1m4n00b6292/UNIDRIVE-V1/Pictures/UNIDRIVE_3D_Back.png

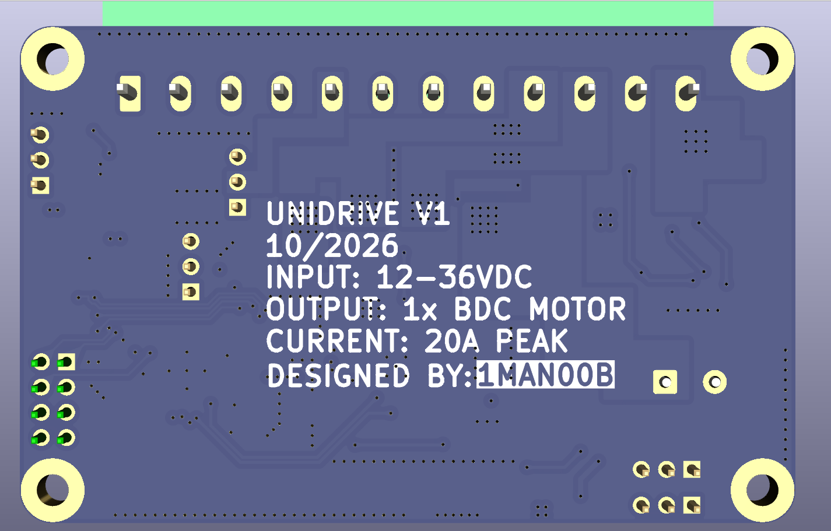
Pictures/UNIDRIVE_3D_Back.png
