1m4n00b6292/UNIDRIVE-V1/Department of Electrical Engineering/PCB/UNIDRIVE V1.csv

Qty | Value | Voltage | Footprint | LCSC Part | MPN
20 | 220uF | 50V | D13mm P5mm
50 | 220nF |  | 0603
20 | 220uF | 50V | Elec_6.3x7.7
50 | 180pF |  | 0603
5 | SMBJ5371B |  | D_SMB
10 | ESD851 |  | SOD-323
10 | 10uH |  | 0420
6 | BSC040N10NS5 |  | SON-8 | C534334 | BSC040N10NS5
50 | 3.5K |  | 0603
50 | 13.7K |  | 0603
10 | 5mR 2W 5% |  | Resistor_SMD:R_2512_6332Metric | C7467241 | FRM252WJR005TN
50 | 13K |  | 0603
50 | 200K |  | 0603
5 | TVS3301DRBR |  | VSON-8 | C2864392 | TVS3301DRBR
5 | LM74502HDDFR |  | SOT-23-8 | C5219202 | LM74502HDDFR
5 | LMR51420YFDDCR |  | SOT-23-6 | C7296200 | LMR51420YFDDCR
5 | AP2112K-3.3 |  | SOT-23-5
5 | STM32G431KBUx |  | QFN-32
5 | DRV8701PRGER |  | VQFN-24 | C114178 | DRV8701PRGER
10 | 24MHz |  | 3225
