1m4n00b6292/UNIDRIVE-V1/Department of Electrical Engineering/PCB/Schematic versions/UNIDRIVE V1 REV2.pdf

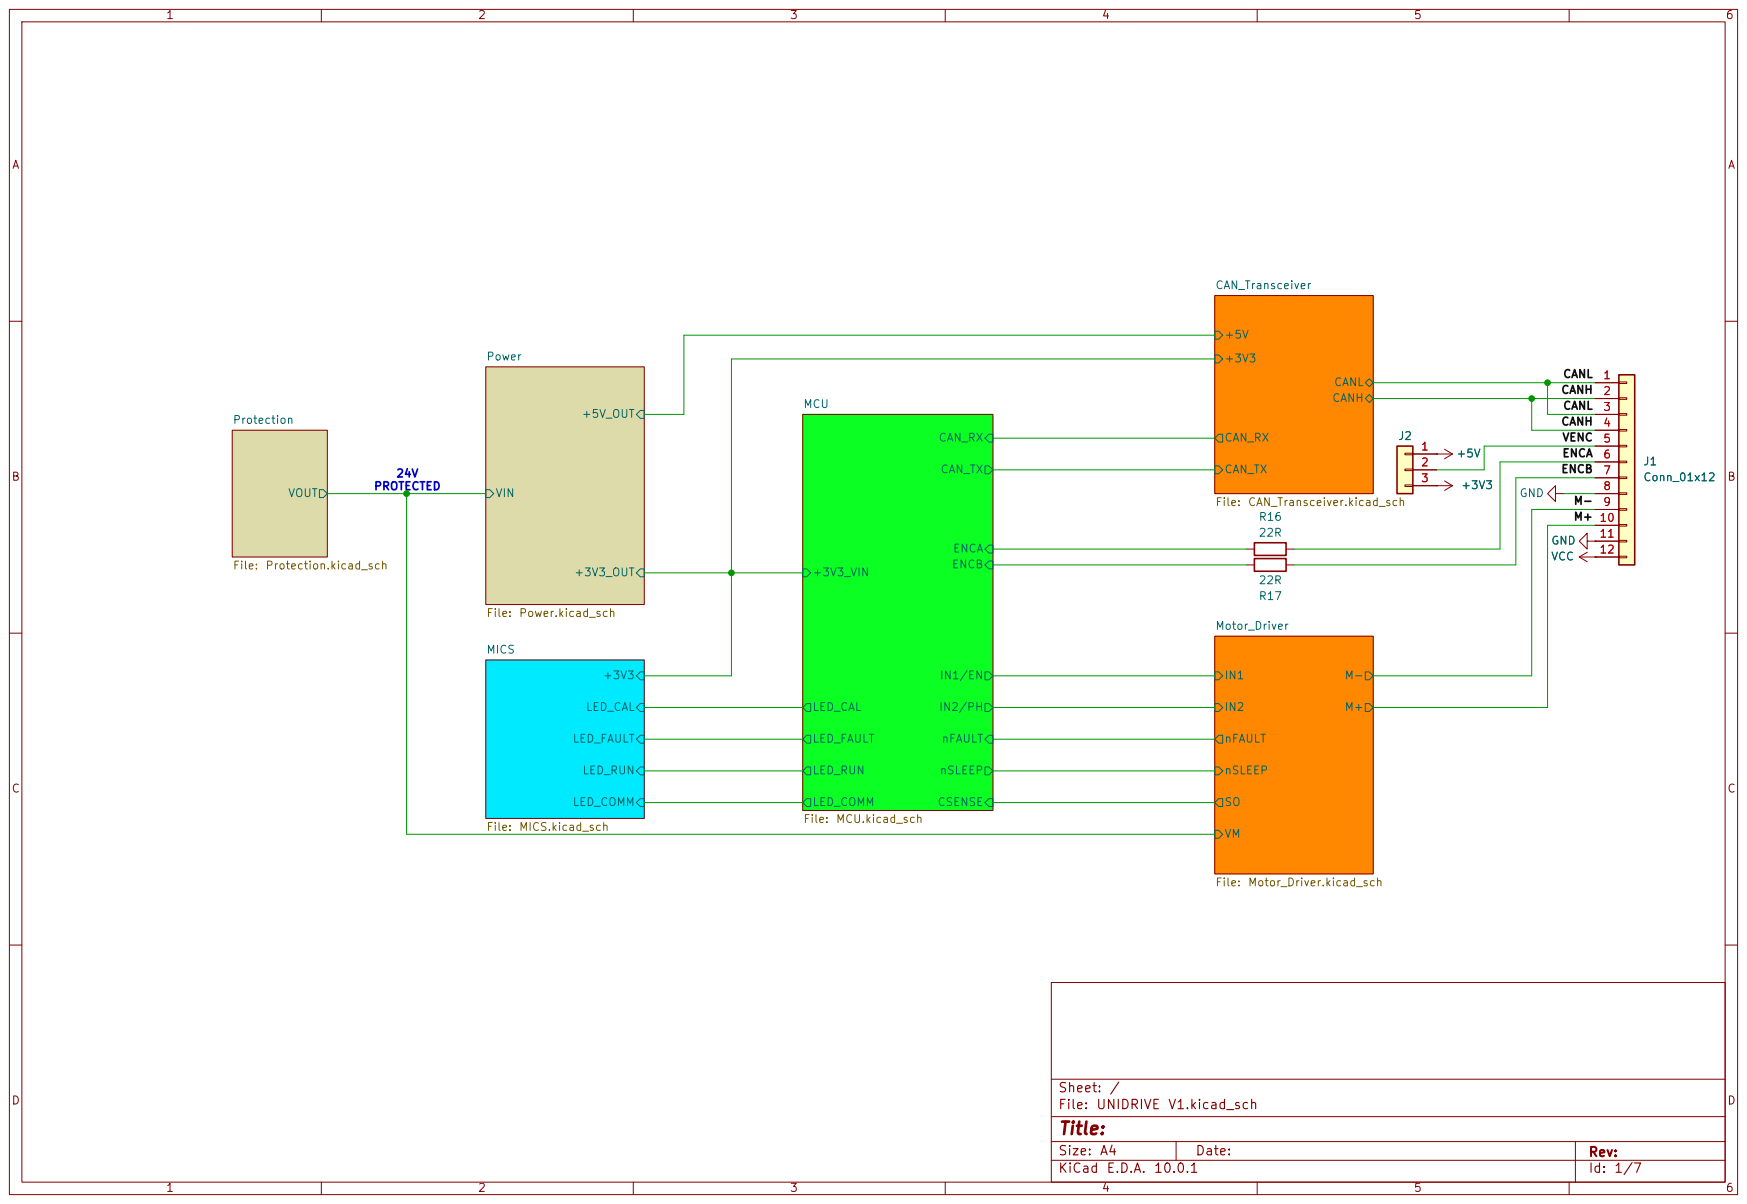
[picture p13: page 1]

CANH 2 2

Size: A4 | Rev:
KiCad E.D.A. 10.0.1 | Id: 1/7

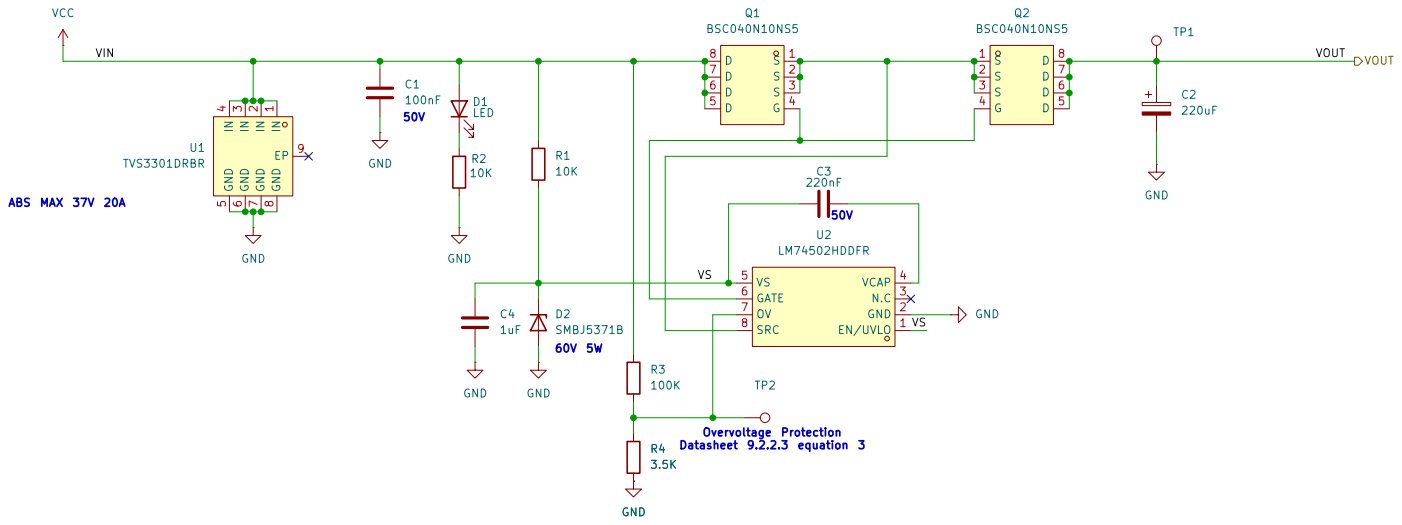
[picture p14: page 2]

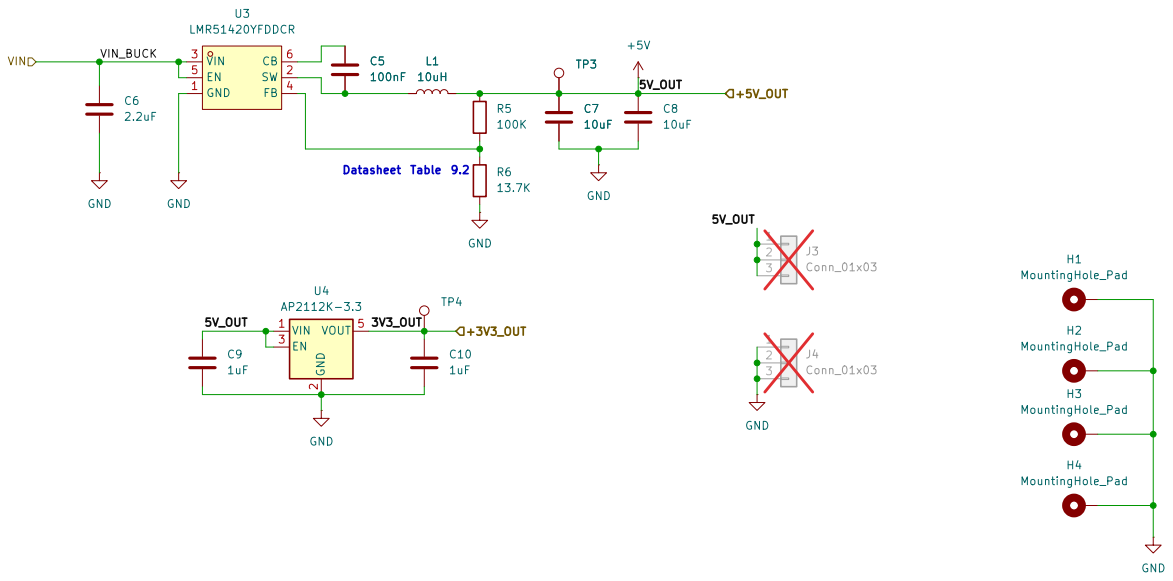
[picture p15: page 3]

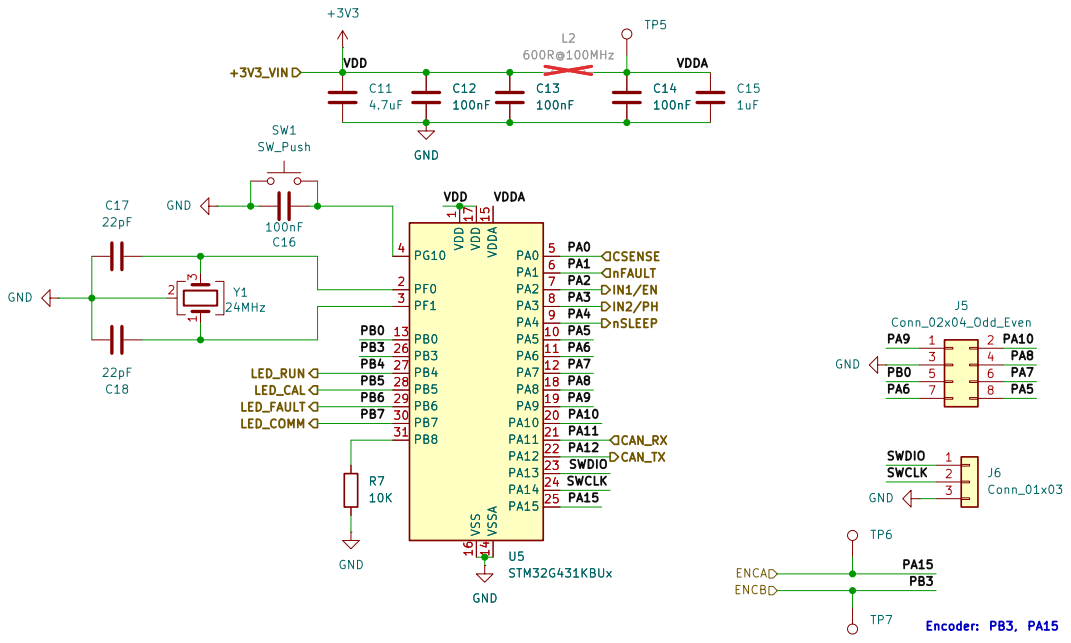
[picture p16: page 4]

1 PF0 2 PF1 3 PG10 4 PA0 5 PA1 6 PA2 7 PA3 8 PA4 9 PA5 10 PA6 11 PA7 12 PB0 13 VSSA 14 VDDA 15 VSS 16 VDD 17 PA8 18 PA9 19 PA10 20 PA11 21 PA12 22 PA13 23 PA14 24 PA15 25 PB3 26 PB4 27 PB5 28 PB6 29 PB7 30 PB8 31 R7

1 PF0 2 PF1 3 PG10 4 PA0 5 PA1 6 PA2 7 PA3 8 PA4 9 PA5 10 PA6 11 PA7 12 PB0 13 VSSA 14 VDDA 15 VSS 16 VDD 17 PA8 18 PA9 19 PA10 20 PA11 21 PA12 22 PA13 23 PA14 24 PA15 25 PB3 26 PB4 27 PB5 28 PB6 29 PB7 30 PB8 31 U5

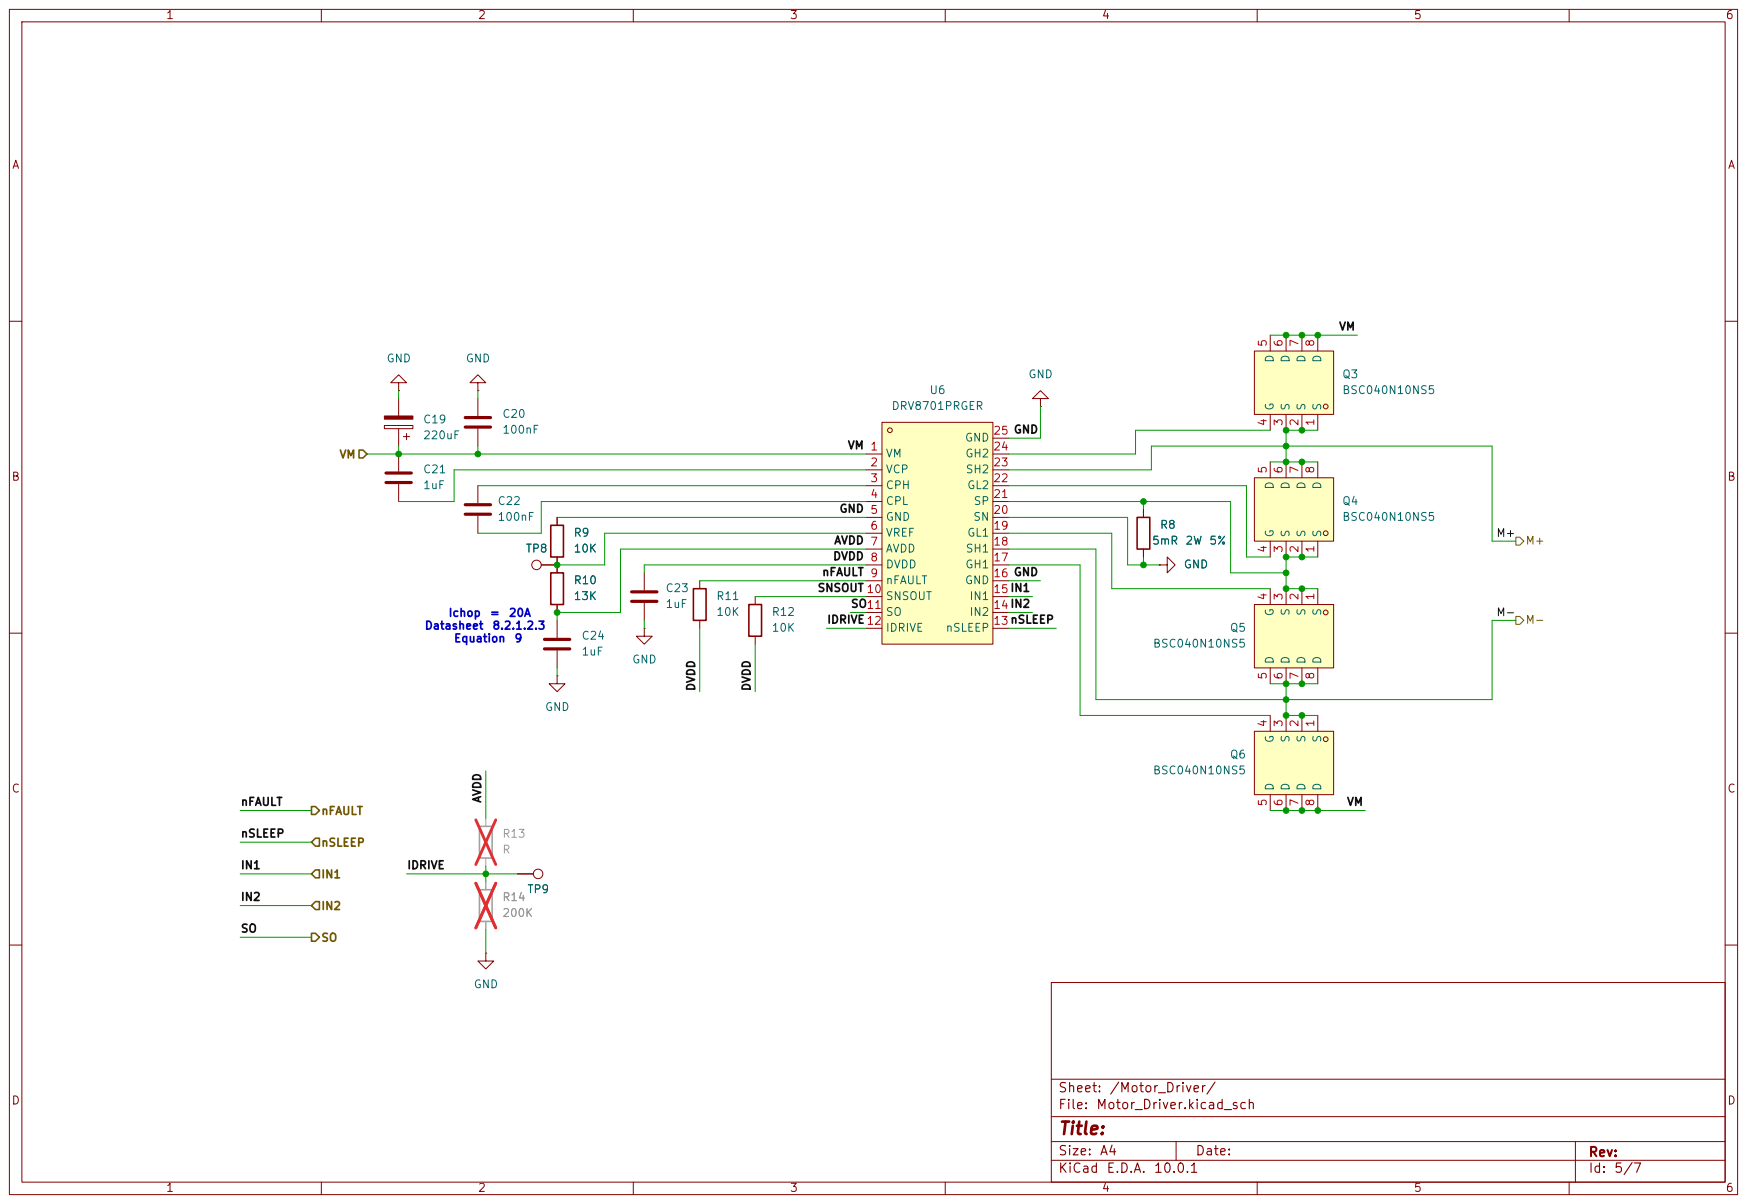
[picture p17: page 5]

nFAULT 9 | GND
SNSOUT 10 | nSLEEP

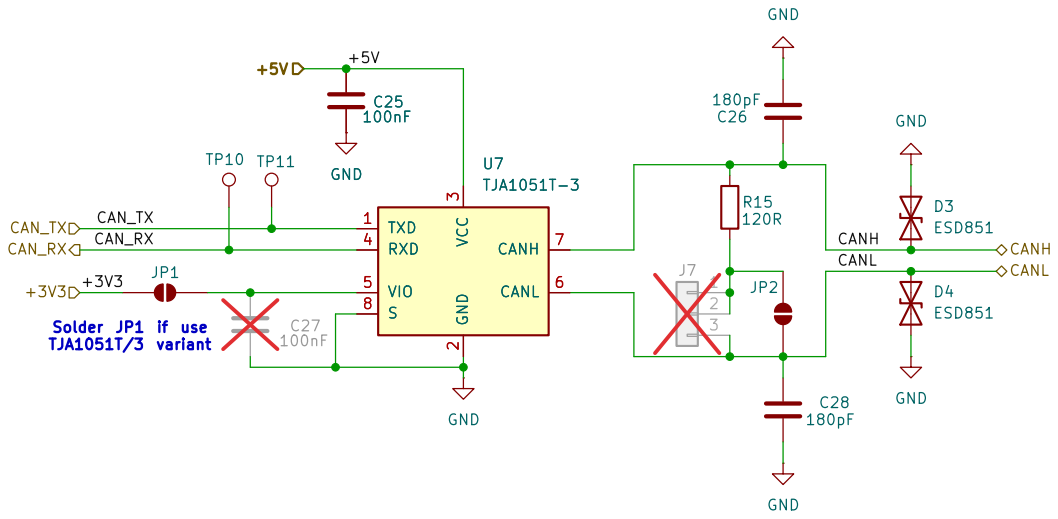
[picture p18: page 6]

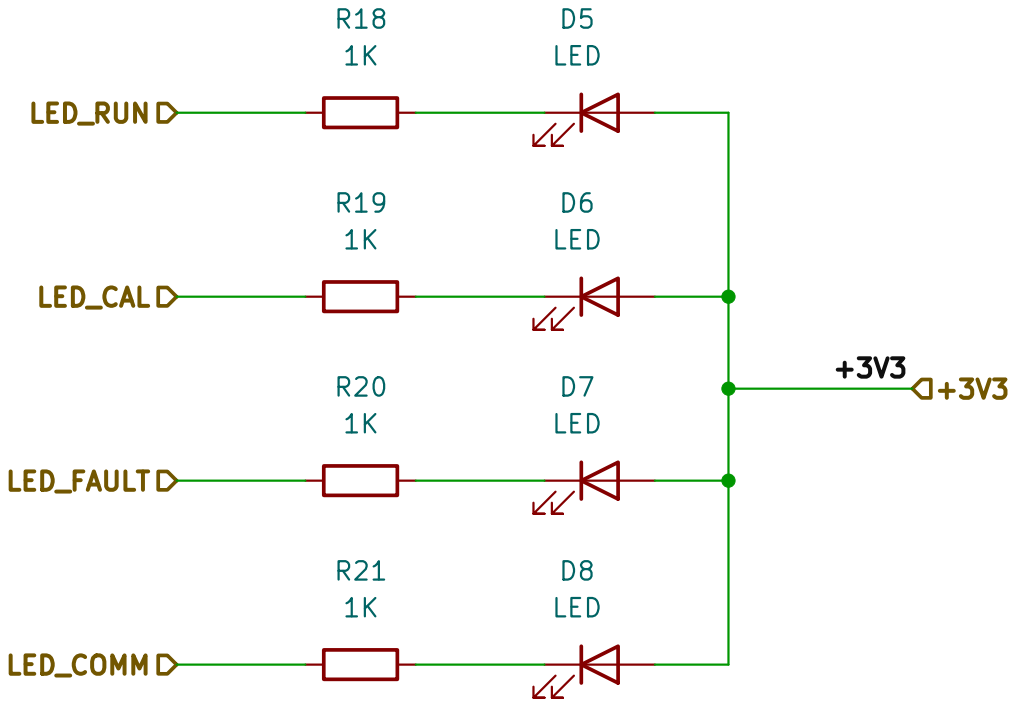
[picture p19: page 7]
