1m4n00b6292/UNIDRIVE-V1/Department of Electrical Engineering/PCB/UNIDRIVE V1.kicad_pcb

## KiCad design Department of Electrical Engineering/PCB/UNIDRIVE V1.kicad_pcb (2026-11-12)

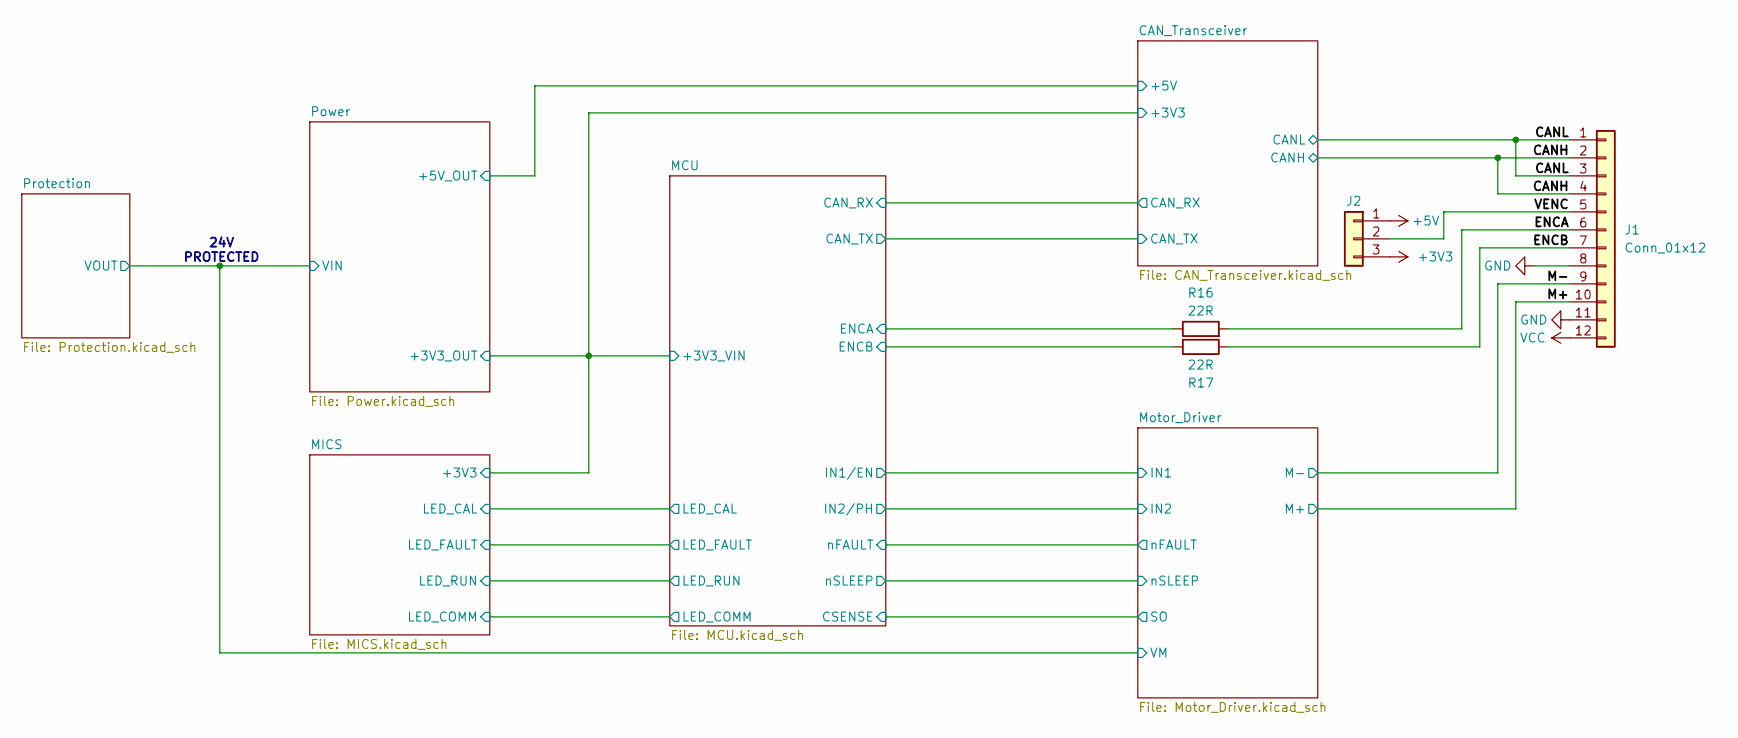
[picture p20: schematic UNIDRIVE V1.kicad_sch]

Parts:
J1: Conn_01x12; PhoenixContact_MSTBA_2,5_12-G-5,08_1x12_P5.08mm_Horizontal
J2: Conn_01x03; PinHeader_1x03_P2.54mm_Vertical
R16, R17: 22R; R_0603_1608Metric_Pad0.98x0.95mm_HandSolder

Connections:
+3V3: J2.3; also elsewhere on the board
+5V: J2.1; also elsewhere on the board
/CANH: J1.2, J1.4; also elsewhere on the board
/CANL: J1.1, J1.3; also elsewhere on the board
/ENCA: J1.6, R16.2
/ENCB: J1.7, R17.1
/M+: J1.10; also elsewhere on the board
/M-: J1.9; also elsewhere on the board
/MCU/PA15: R16.1; also elsewhere on the board
/MCU/PB3: R17.2; also elsewhere on the board
/VENC: J1.5, J2.2
GND: J1.8, J1.11; also elsewhere on the board
VCC: J1.12; also elsewhere on the board

Notes on the sheet:
24V PROTECTED

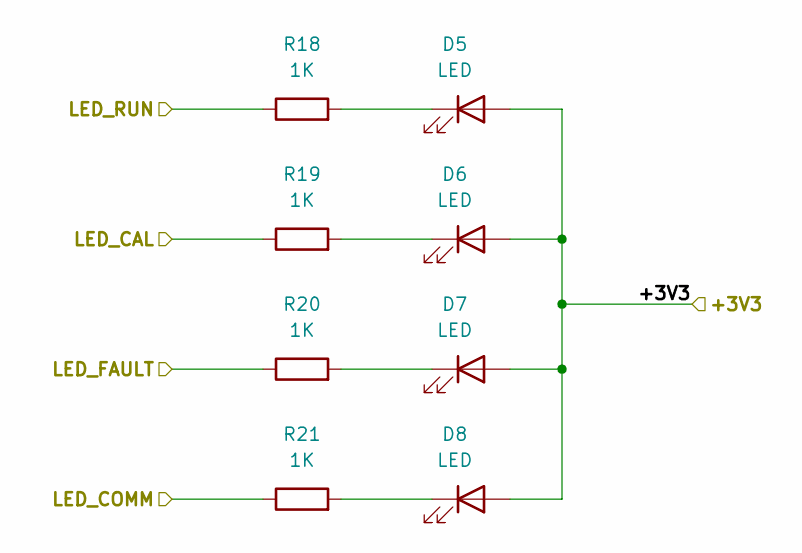
[picture p21: schematic MICS.kicad_sch]

Parts:
D5, D6, D7, D8: LED; LED_1206_3216Metric
R18, R19, R20, R21: 1K; R_0603_1608Metric_Pad0.98x0.95mm_HandSolder

Connections:
+3V3: D5.2 (A), D6.2 (A), D7.2 (A), D8.2 (A); also elsewhere on the board
/MCU/PB4: R18.1; also elsewhere on the board
/MCU/PB5: R19.1; also elsewhere on the board
/MCU/PB6: R20.1; also elsewhere on the board
/MCU/PB7: R21.1; also elsewhere on the board
unnamed: D5.1 (K), R18.2
unnamed: D6.1 (K), R19.2
unnamed: D7.1 (K), R20.2
unnamed: D8.1 (K), R21.2

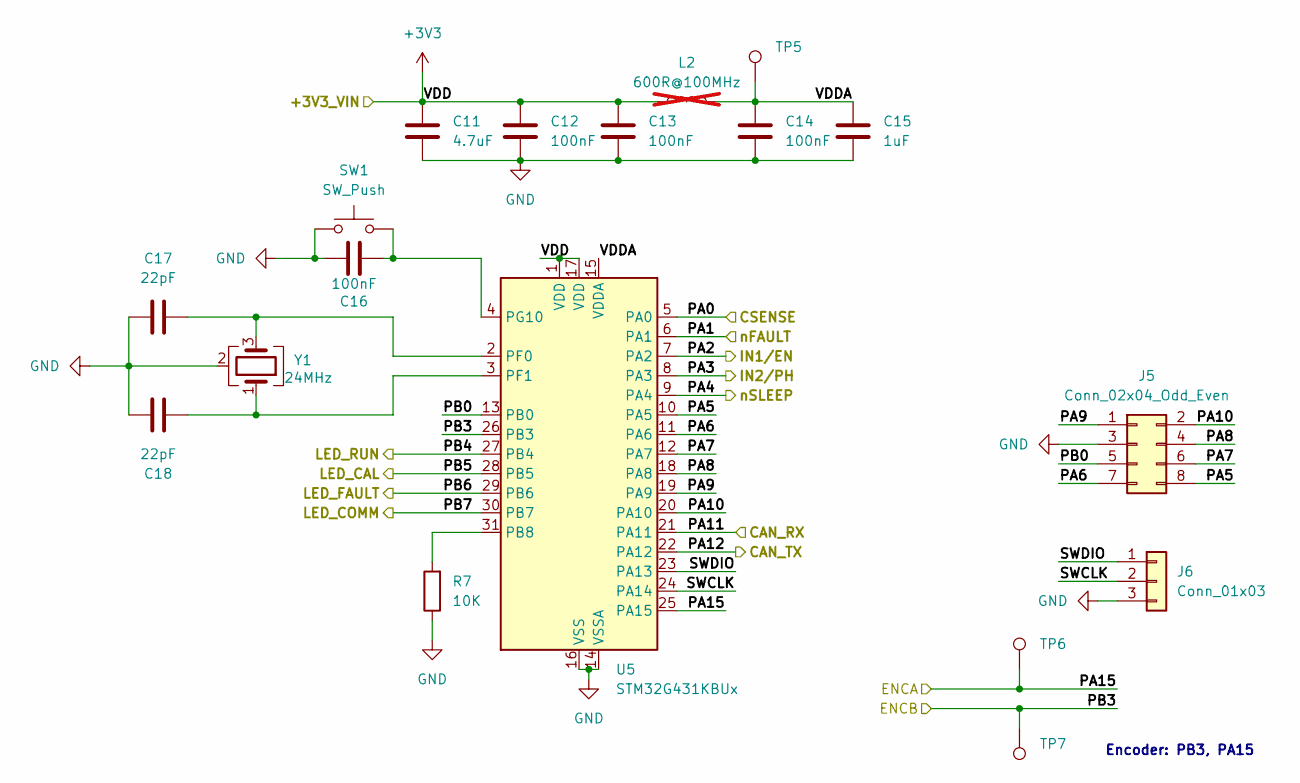
[picture p22: schematic MCU.kicad_sch]

Parts:
C11: 4.7uF; C_0603_1608Metric_Pad1.08x0.95mm_HandSolder
C12, C13, C14, C16: 100nF; C_0603_1608Metric_Pad1.08x0.95mm_HandSolder
C15: 1uF; C_0603_1608Metric_Pad1.08x0.95mm_HandSolder
C17, C18: 22pF; C_0603_1608Metric_Pad1.08x0.95mm_HandSolder
J5: Conn_02x04_Odd_Even; PinHeader_2x04_P2.54mm_Vertical
J6: Conn_01x03; PinHeader_1x03_P2.54mm_Vertical
L2: 600R@100MHz; L_0805_2012Metric_Pad1.05x1.20mm_HandSolder; not fitted
R7: 10K; R_0603_1608Metric_Pad0.98x0.95mm_HandSolder
SW1: SW_Push; SW_SPST_CK_RS282G05A3
TP5, TP6, TP7: TestPoint; TestPoint_Pad_D1.0mm
U5: STM32G431KBUx; QFN-32-1EP_5x5mm_P0.5mm_EP3.45x3.45mm
Y1: 24MHz; Crystal_SMD_3225-4Pin_3.2x2.5mm

Connections:
+3V3: C11.1, C12.1, C13.1, L2.1, U5.1 (VDD), U5.17 (VDD); also elsewhere on the board
/CAN_Transceiver/CAN_RX: U5.21 (PA11); also elsewhere on the board
/CAN_Transceiver/CAN_TX: U5.22 (PA12); also elsewhere on the board
/MCU/PA0: U5.5 (PA0); also elsewhere on the board
/MCU/PA1: U5.6 (PA1); also elsewhere on the board
/MCU/PA2: U5.7 (PA2); also elsewhere on the board
/MCU/PA3: U5.8 (PA3); also elsewhere on the board
/MCU/PA4: U5.9 (PA4); also elsewhere on the board
/MCU/PA5: J5.8, U5.10 (PA5)
/MCU/PA6: J5.7, U5.11 (PA6)
/MCU/PA7: J5.6, U5.12 (PA7)
/MCU/PA8: J5.4, U5.18 (PA8)
/MCU/PA9: J5.1, U5.19 (PA9)
/MCU/PA10: J5.2, U5.20 (PA10)
/MCU/PA15: TP6.1 (1_1), U5.25 (PA15); also elsewhere on the board
/MCU/PB0: J5.5, U5.13 (PB0)
/MCU/PB3: TP7.1 (1_1), U5.26 (PB3); also elsewhere on the board
/MCU/PB4: U5.27 (PB4); also elsewhere on the board
/MCU/PB5: U5.28 (PB5); also elsewhere on the board
/MCU/PB6: U5.29 (PB6); also elsewhere on the board
/MCU/PB7: U5.30 (PB7); also elsewhere on the board
/MCU/SWCLK: J6.2, U5.24 (PA14)
/MCU/SWDIO: J6.1, U5.23 (PA13)
/MCU/VDDA: C14.1, C15.1, L2.2, TP5.1 (1_1), U5.15 (VDDA)
GND: C11.2, C12.2, C13.2, C14.2, C15.2, C16.1, C17.2, C18.2, J5.3, J6.3, R7.1, SW1.1, U5.14 (VSSA), U5.16 (VSS), U5.32 (VSS), U5.33 (VSS), Y1.2 (G), Y1.4 (G); also elsewhere on the board
unnamed: R7.2, U5.31 (PB8)
unnamed: C17.1, U5.2 (PF0), Y1.3
unnamed: C18.1, U5.3 (PF1), Y1.1
unnamed: C16.2, SW1.2, U5.4 (PG10)

Notes on the sheet:
Encoder: PB3, PA15

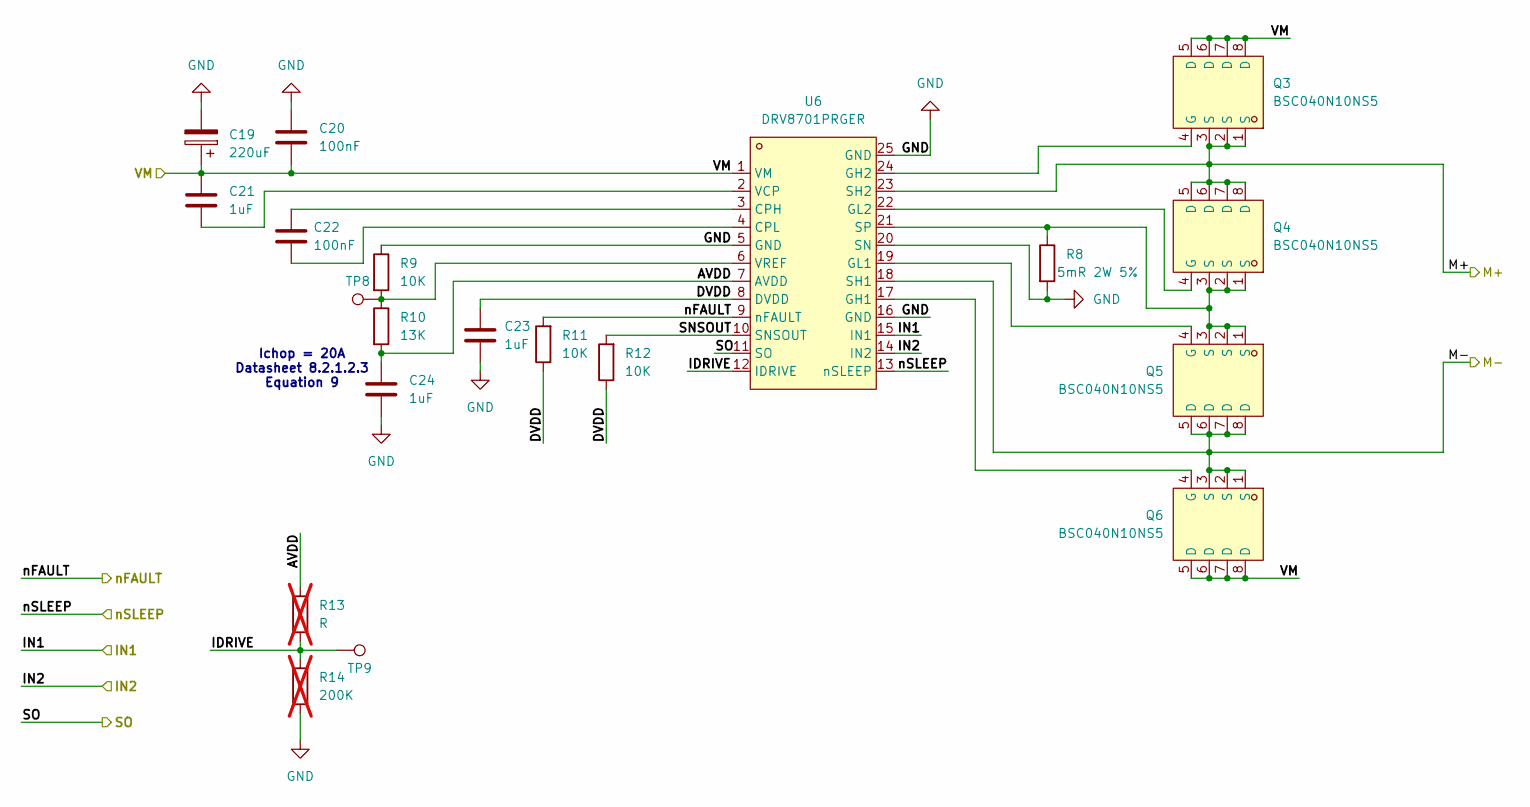
[picture p23: schematic Motor_Driver.kicad_sch]

Parts:
C19: 220uF; CP_Elec_6.3x7.7
C20, C22: 100nF; C_0603_1608Metric_Pad1.08x0.95mm_HandSolder
C21, C23, C24: 1uF; C_0603_1608Metric_Pad1.08x0.95mm_HandSolder
Q3, Q4, Q5, Q6: BSC040N10NS5; PG-TDSON-8_L5.9-W5.1-P1.27-LS6.1-BL; MPN BSC040N10NS5; LCSC Part C534334
R8: 5mR 2W 5%; R_2512_6332Metric; MPN FRM252WJR005TN; LCSC C7467241
R9, R11, R12: 10K; R_0603_1608Metric_Pad0.98x0.95mm_HandSolder
R10: 13K; R_0603_1608Metric_Pad0.98x0.95mm_HandSolder
R13: R; R_0603_1608Metric_Pad0.98x0.95mm_HandSolder; not fitted
R14: 200K; R_0603_1608Metric_Pad0.98x0.95mm_HandSolder; not fitted
TP8, TP9: TestPoint; TestPoint_Pad_D1.0mm
U6: DRV8701PRGER; VQFN-24_L4.0-W4.0-P0.50-BL-EP2.8; MPN DRV8701PRGER; LCSC Part C114178

Connections:
/M+: Q3.1 (S), Q3.2 (S), Q3.3 (S), Q4.5 (D), Q4.6 (D), Q4.7 (D), Q4.8 (D), U6.23 (SH2); also elsewhere on the board
/M-: Q5.5 (D), Q5.6 (D), Q5.7 (D), Q5.8 (D), Q6.1 (S), Q6.2 (S), Q6.3 (S), U6.18 (SH1); also elsewhere on the board
/MCU/PA0: U6.11 (SO); also elsewhere on the board
/MCU/PA1: R11.2, U6.9 (nFAULT); also elsewhere on the board
/MCU/PA2: U6.15 (IN1); also elsewhere on the board
/MCU/PA3: U6.14 (IN2); also elsewhere on the board
/MCU/PA4: U6.13 (nSLEEP); also elsewhere on the board
/Motor_Driver/AVDD: C24.1, R10.2, R13.2, U6.7 (AVDD)
/Motor_Driver/DVDD: C23.1, R11.1, R12.1, U6.8 (DVDD)
/Motor_Driver/IDRIVE: R13.1, R14.2, TP9.1 (1_1), U6.12 (IDRIVE)
/Motor_Driver/SNSOUT: R12.2, U6.10 (SNSOUT)
/Motor_Driver/VM: C19.1, C20.2, C21.1, Q3.5 (D), Q3.6 (D), Q3.7 (D), Q3.8 (D), Q6.5 (D), Q6.6 (D), Q6.7 (D), Q6.8 (D), U6.1 (VM); also elsewhere on the board
GND: C19.2, C20.1, C23.2, C24.2, R8.2, R9.1, R14.1, U6.5 (GND), U6.16 (GND), U6.20 (SN), U6.25 (GND); also elsewhere on the board
unnamed: Q3.4 (G), U6.24 (GH2)
unnamed: Q4.4 (G), U6.22 (GL2)
unnamed: Q5.4 (G), U6.19 (GL1)
unnamed: Q6.4 (G), U6.17 (GH1)
unnamed: C22.1, U6.3 (CPH)
unnamed: C22.2, U6.4 (CPL)
unnamed: Q4.1 (S), Q4.2 (S), Q4.3 (S), Q5.1 (S), Q5.2 (S), Q5.3 (S), R8.1, U6.21 (SP)
unnamed: C21.2, U6.2 (VCP)
unnamed: R9.2, R10.1, TP8.1 (1_1), U6.6 (VREF)

Notes on the sheet:
Ichop = 20A Datasheet 8.2.1.2.3 Equation 9

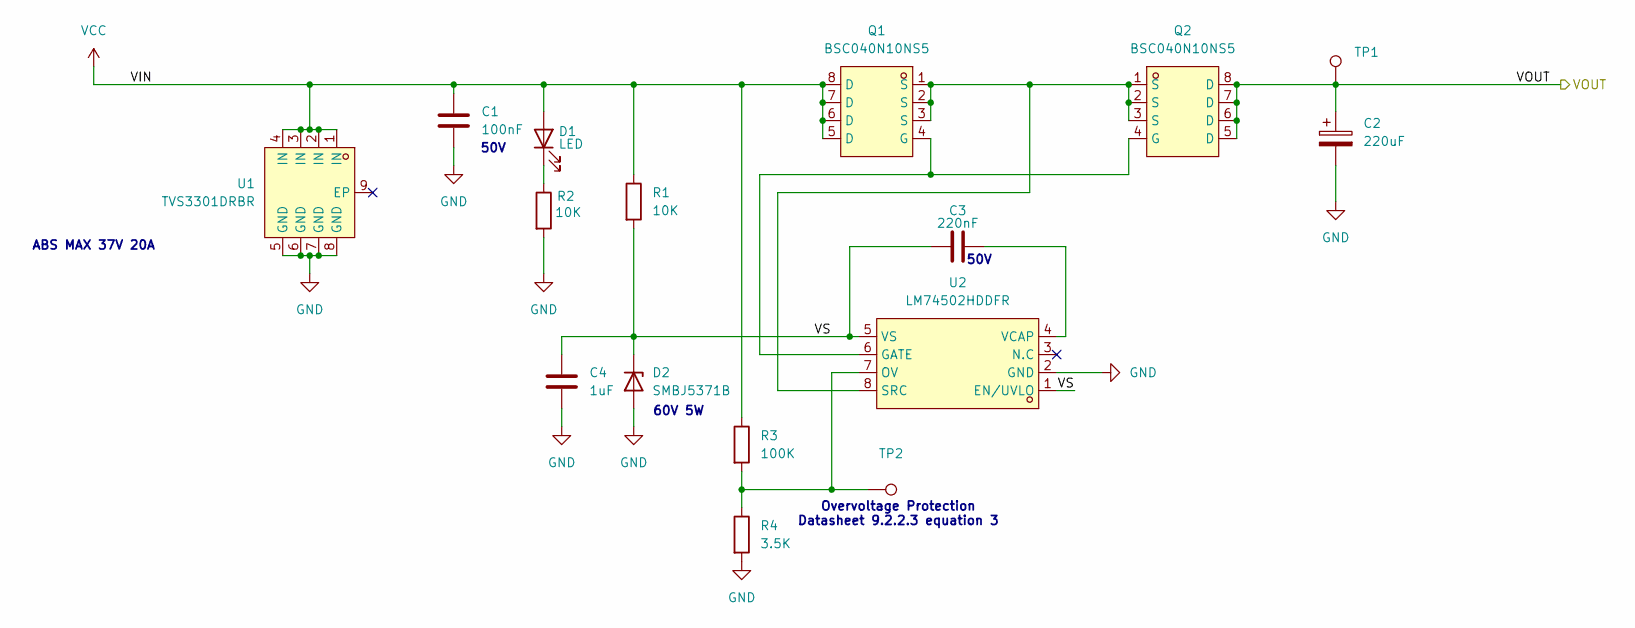
[picture p24: schematic Protection.kicad_sch]

Parts:
C1: 100nF; C_1206_3216Metric
C2: 220uF; CP_Radial_D13.0mm_P5.00mm
C3: 220nF; C_0603_1608Metric_Pad1.08x0.95mm_HandSolder
C4: 1uF; C_1206_3216Metric
D1: LED; LED_1206_3216Metric
D2: SMBJ5371B; D_SMB_Handsoldering
Q1, Q2: BSC040N10NS5; PG-TDSON-8_L5.9-W5.1-P1.27-LS6.1-BL; MPN BSC040N10NS5; LCSC Part C534334
R1, R2: 10K; R_1206_3216Metric
R3: 100K; R_0603_1608Metric_Pad0.98x0.95mm_HandSolder
R4: 3.5K; R_0603_1608Metric_Pad0.98x0.95mm_HandSolder
TP1, TP2: TestPoint; TestPoint_Pad_D1.0mm
U1: TVS3301DRBR; VSON-8_L3.0-W3.0-P0.65-BL-EP; MPN TVS3301DRBR; LCSC Part C2864392
U2: LM74502HDDFR; SOT-23-8_L2.9-W1.6-P0.65-LS2.8-BL; MPN LM74502HDDFR; LCSC Part C5219202

Connections:
/Motor_Driver/VM: C2.1, Q2.5 (D), Q2.6 (D), Q2.7 (D), Q2.8 (D), TP1.1 (1_1); also elsewhere on the board
/Protection/VS: C3.1, C4.1, D2.1 (K), R1.2, U2.1 (EN/UVLO), U2.5 (VS)
GND: C1.2, C2.2, C4.2, D2.2 (A), R2.2, R4.2, U1.5 (GND), U1.6 (GND), U1.7 (GND), U1.8 (GND), U2.2 (GND); also elsewhere on the board
unnamed: D1.1 (K), R2.1
unnamed: Q1.4 (G), Q2.4 (G), U2.6 (GATE)
unnamed: R3.2, R4.1, TP2.1 (1_1), U2.7 (OV)
unnamed: Q1.1 (S), Q1.2 (S), Q1.3 (S), Q2.1 (S), Q2.2 (S), Q2.3 (S), U2.8 (SRC)
unnamed: C3.2, U2.4 (VCAP)
VCC: C1.1, D1.2 (A), Q1.5 (D), Q1.6 (D), Q1.7 (D), Q1.8 (D), R1.1, R3.1, U1.1 (IN), U1.2 (IN), U1.3 (IN), U1.4 (IN); also elsewhere on the board

Notes on the sheet:
60V 5W
ABS MAX 37V 20A
Overvoltage Protection Datasheet 9.2.2.3 equation 3
50V

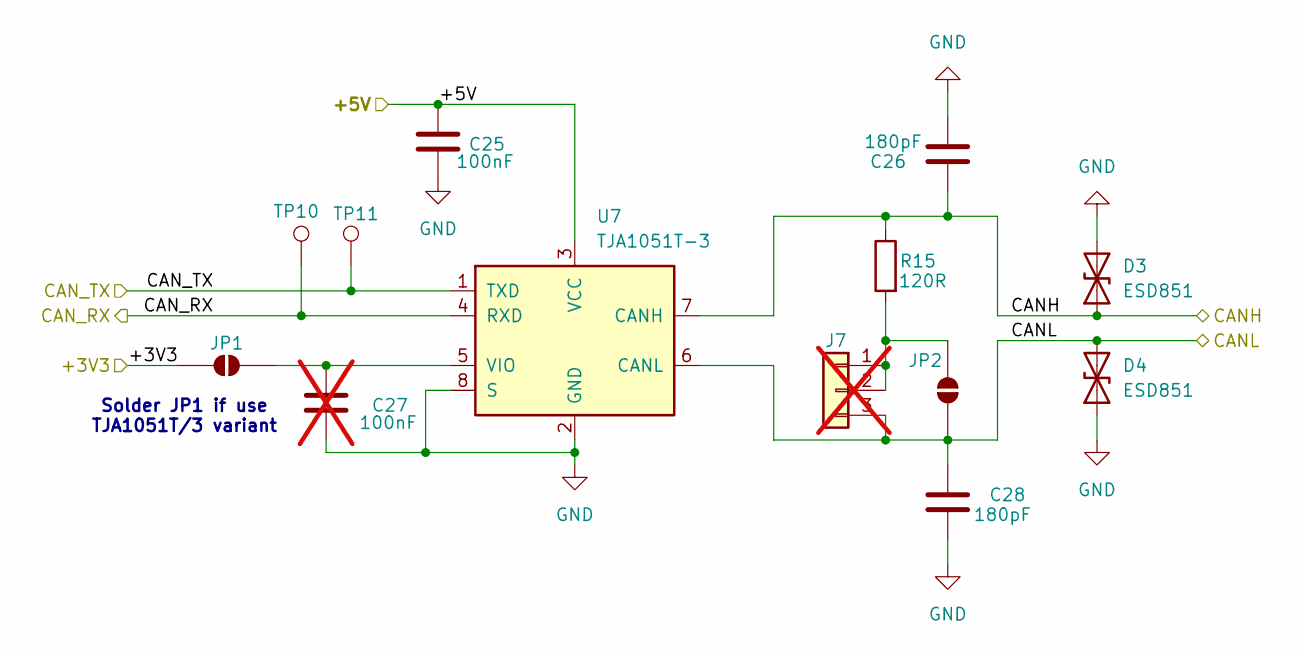
[picture p25: schematic CAN_Transceiver.kicad_sch]

Parts:
C25: 100nF; C_0603_1608Metric_Pad1.08x0.95mm_HandSolder
C26, C28: 180pF; C_0603_1608Metric_Pad1.08x0.95mm_HandSolder
C27: 100nF; C_0603_1608Metric_Pad1.08x0.95mm_HandSolder; not fitted
D3, D4: ESD851; D_SOD-323_HandSoldering
J7: Conn_01x03; PinHeader_1x03_P2.54mm_Vertical; not fitted
JP1, JP2: SolderJumper_2_Open; SolderJumper-2_P1.3mm_Open_TrianglePad1.0x1.5mm
R15: 120R; R_0603_1608Metric_Pad0.98x0.95mm_HandSolder
TP10, TP11: TestPoint; TestPoint_Pad_D1.0mm
U7: TJA1051T-3; SOIC-8_3.9x4.9mm_P1.27mm

Connections:
+3V3: JP1.2 (B); also elsewhere on the board
+5V: C25.1, U7.3 (VCC); also elsewhere on the board
/CANH: C26.1, D3.1 (A1), R15.1, U7.7 (CANH); also elsewhere on the board
/CANL: C28.1, D4.2 (A2), J7.3, JP2.2 (B), U7.6 (CANL); also elsewhere on the board
/CAN_Transceiver/CAN_RX: TP10.1 (1_1), U7.4 (RXD); also elsewhere on the board
/CAN_Transceiver/CAN_TX: TP11.1 (1_1), U7.1 (TXD); also elsewhere on the board
GND: C25.2, C26.2, C27.2, C28.2, D3.2 (A2), D4.1 (A1), U7.2 (GND), U7.8 (S); also elsewhere on the board
unnamed: J7.1, J7.2, JP2.1 (A), R15.2
unnamed: C27.1, JP1.1 (A), U7.5 (VIO)

Notes on the sheet:
Solder JP1 if use TJA1051T/3 variant

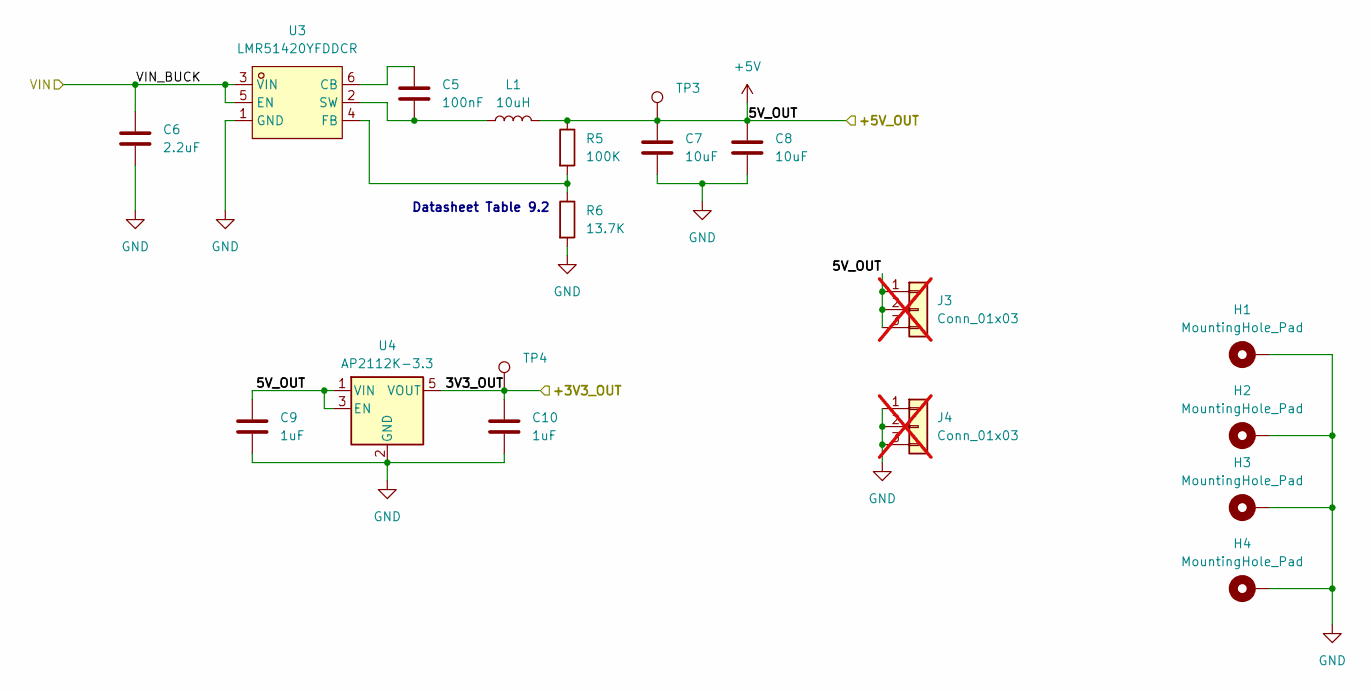
[picture p26: schematic Power.kicad_sch]

Parts:
C5: 100nF; C_0603_1608Metric_Pad1.08x0.95mm_HandSolder
C6: 2.2uF; C_0603_1608Metric_Pad1.08x0.95mm_HandSolder
C7, C8: 10uF; C_1206_3216Metric_Pad1.33x1.80mm_HandSolder
C9, C10: 1uF; C_1206_3216Metric_Pad1.33x1.80mm_HandSolder
H1, H2, H3, H4: MountingHole_Pad; MountingHole_3.2mm_M3_Pad_TopBottom
J3, J4: Conn_01x03; PinHeader_1x03_P2.54mm_Vertical; not fitted
L1: 10uH; L_Vishay_IHLP-1616
R5: 100K; R_0603_1608Metric_Pad0.98x0.95mm_HandSolder
R6: 13.7K; R_0603_1608Metric_Pad0.98x0.95mm_HandSolder
TP3, TP4: TestPoint; TestPoint_Pad_D1.0mm
U3: LMR51420YFDDCR; SOT-23-6_L2.9-W1.6-P0.95-LS2.8-BL; MPN LMR51420YFDDCR; LCSC Part C7296200
U4: AP2112K-3.3; SOT-23-5

Connections:
+3V3: C10.1, TP4.1 (1_1), U4.5 (VOUT); also elsewhere on the board
+5V: C7.1, C8.1, C9.1, J3.1, J3.2, J3.3, L1.2, R5.1, TP3.1 (1_1), U4.1 (VIN), U4.3 (EN); also elsewhere on the board
/Motor_Driver/VM: C6.1, U3.3 (VIN), U3.5 (EN); also elsewhere on the board
GND: C6.2, C7.2, C8.2, C9.2, C10.2, H1.1 (1_1), H2.1 (1_1), H3.1 (1_1), H4.1 (1_1), J4.1, J4.2, J4.3, R6.2, U3.1 (GND), U4.2 (GND); also elsewhere on the board
unnamed: C5.1, U3.6 (CB)
unnamed: R5.2, R6.1, U3.4 (FB)
unnamed: C5.2, L1.1, U3.2 (SW)

Notes on the sheet:
Datasheet Table 9.2

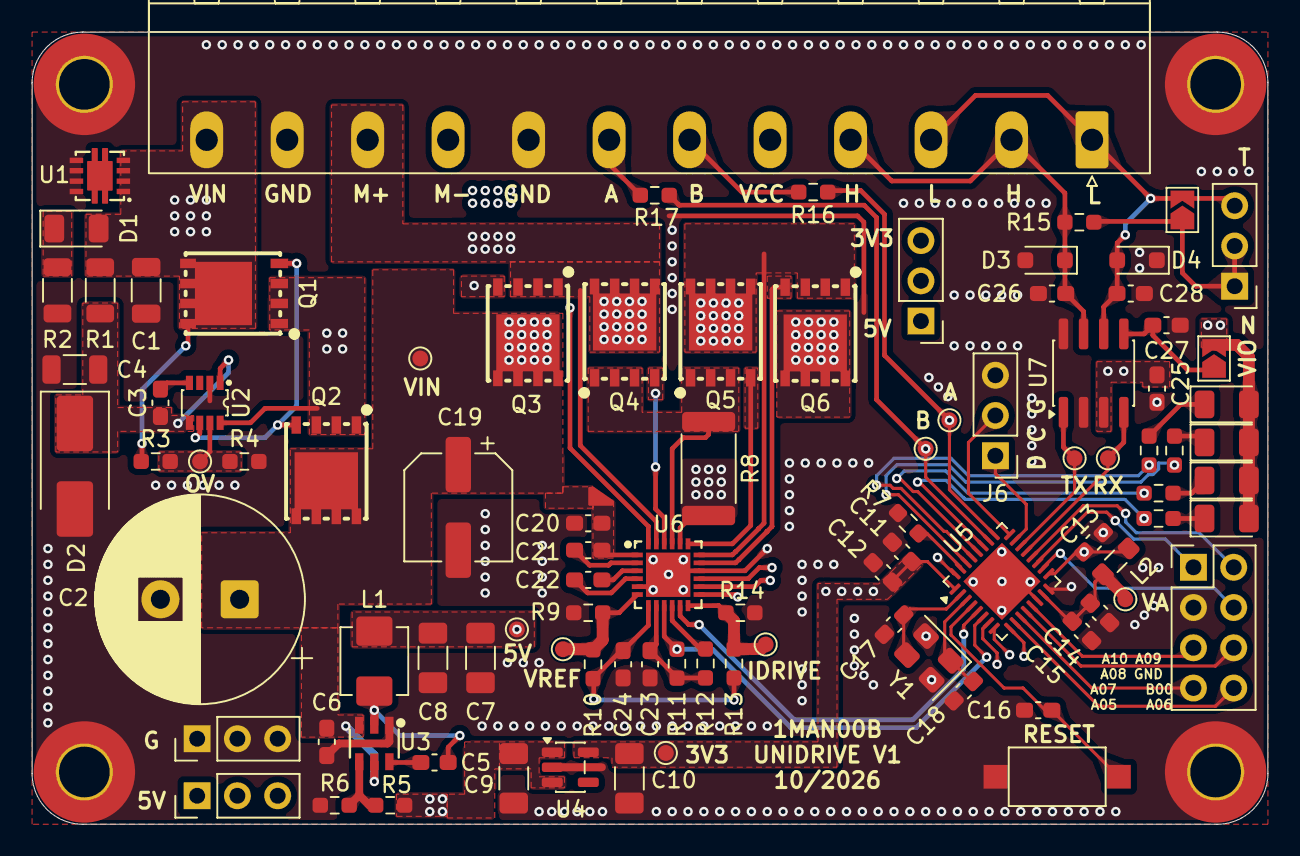
[picture p27: board UNIDRIVE V1.kicad_pcb from above]

Board: 4 copper layers, 78.0 x 50.0 mm, 98 parts (0 on the bottom side), 67 nets.
